ryood/PSoC-PyunPyun-3rdLPF/PSoC_PyunPyun_3rdLPF.cydsn/ComponentUpdateLog.txt

Last Modified Date & Time: 04/29/2015 00:29:26

PSoC_PyunPyun_3rdLPF: TopDesign
	ADC_SAR_Seq [v2.0] to [v2.10]
