ryood/PSoC-PyunPyun-3rdLPF/PyunPyun3_Test.xlsx

PyunPyun3 3rdLPF シールド テスト表
 | 電源なし、部品の挿入なし
 | Point1 | Point2 | 値 | 2015.04.28 #1 | 2015.04.28 #2
 | IC1-1 | IC1-2 | 導通 | OK
 | IC1-1 | C2 | 導通 | NG | OK
 | IC1-1 | C3 | 導通 | OK
 | IC1-3 | C1 | 導通 | OK
 | IC1-3 | R2 | 導通 | OK
 | IC1-4 | TP-GND | 導通 | OK
 | IC1-5 | R9 | 導通 | OK
 | IC1-5 | R10 | 導通 | OK
 | IC1-5 | TP-GND | 10kΩ | 9.97kΩ
 | IC1-5 | JP1-5 | 10kΩ | 9.90kΩ
 | IC1-6 | IC1-7 | 導通 | OK
 | IC1-7 | C7 | 導通 | OK
 | IC1-7 | C8 | 導通 | OK
 | IC1-7 | JP8 | 導通 | OK
 | IC1-8 | JP1-5 | 導通 | OK
 | R3 | JP8 | 導通 | OK
 | R3 | R5 | 導通 | OK
 | R3 | JP3-8 | 導通 | OK
 | R3 | C4 | 導通 | OK
 | R5 | C4 | 導通 | OK
 | R5 | R1 | 導通 | OK
 | C4 | R1 | 導通 | OK
 | R1 | R2 | 導通 | OK
 | R1 | C2 | 導通 | OK
 | C1 | TP-VGND | 導通 | OK
 | C3 | JP5-1 | 導通 | OK
 | C3 | TP-VGND | 10kΩ | 9.87kΩ
 | R4 | TP-VGND | 導通 | OK
 | JP1-4 | JP4-1 | 導通 | OK
 | JP1-5 | R9 | 導通 | OK
 | JP1-7 | TP-GND | 導通 | OK
 | R9 | C8 | 導通 | OK（裏面でチェック）
 | R9 | R10 | 導通 | OK
 | R10 | TP-GND | 導通 | OK
 | R10 | C7 | 導通 | OK（裏面でチェック）
 | JP3-1 | JP4-6 | 導通 | OK
 | JP3-2 | JP4-5 | 導通 | OK
 | JP3-5 | R6 | 導通 | OK
 | JP4-4 | TP-VGND | 導通 | OK
 | JP4-7 | TP-VGND | 2.2kΩ | 2.17kΩ
 | JP4-7 | R6 | 導通 | OK
 | JP4-8 | TP-GND | 導通 | OK
 | JP4-9 | JP1-5 | 1kΩ | 986Ω
 | C7 | TP-GND | 導通 | OK
 | C9 | JP1-5 | 導通 | OK
 | C9 | TP-VGND | 導通 | OK
 | C10 | TP-VGND | 導通 | OK
 | C10 | TP-GND | 導通 | OK
 | シールドをPSoCに挿入
 | Point1 | Point2 | 値 | 2015.04.28 #1
 | IC1-4 | TP-GND | 0V | 0.00mV
 | IC1-8 | TP-GND | 5V | 4.76V
 | JP4-1 | TP-GND | 3.3V | 3.47V
 | CR,OPAMP挿入(LCDは挿入しない)
 | Point1 | Point2 | 値 | 2015.04.28 #1
 | TP-AGND | TP-GND | 2.5V | 2.37V
