ryood/PSoC-PyunPyun-3rdLPF/(list of files, drawings)

Other design files:
Fritzing/PSoC_PyunPyun_3rdLPF.fzz
