ryood/PSoC-PyunPyun-3rdLPF/Eagle/PSoC_PyunPyun_Mini.brd

## EAGLE design Eagle/PSoC_PyunPyun_Mini.brd (2015-04-28)

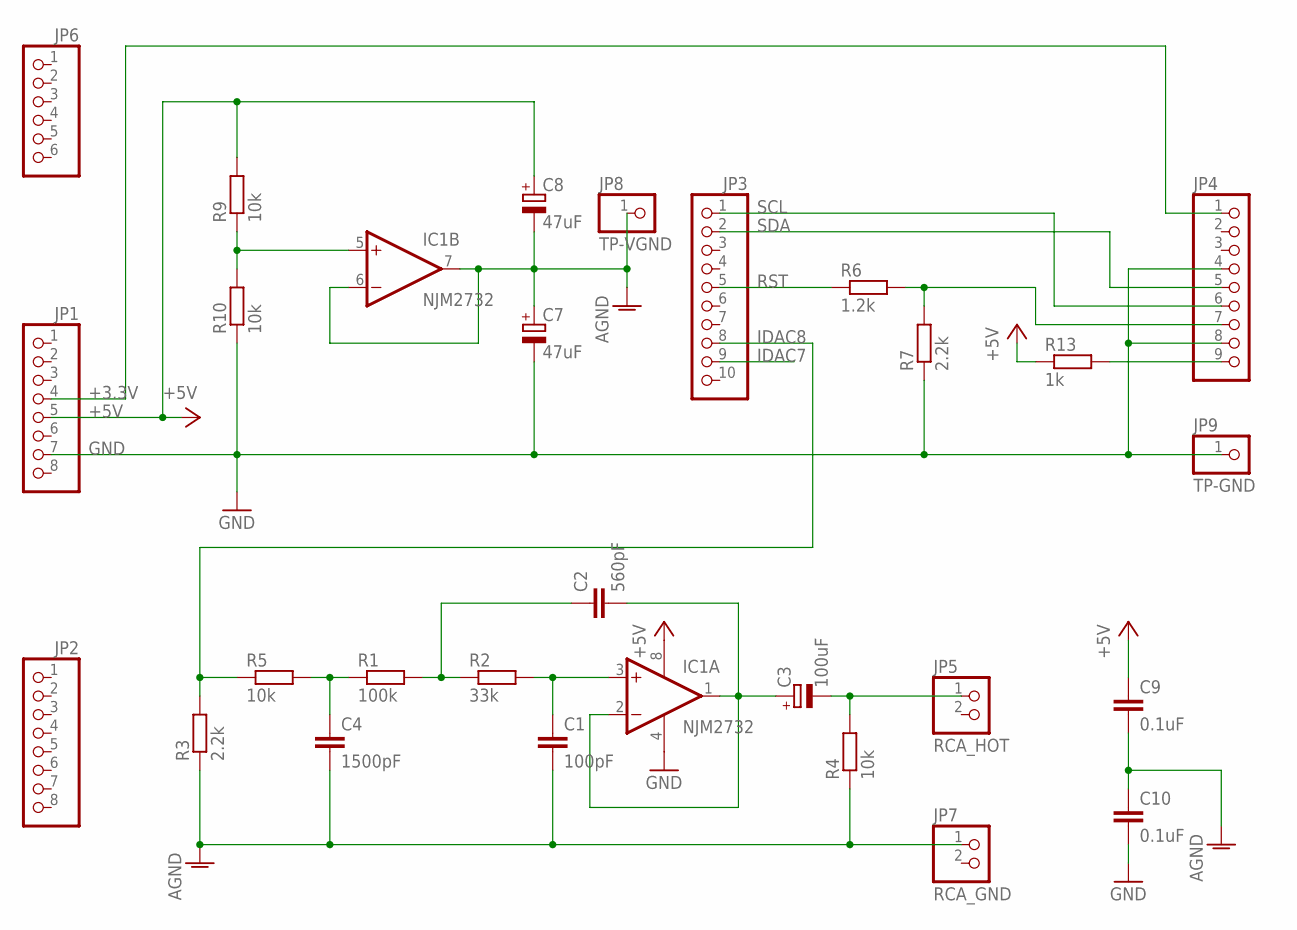
[picture p1: schematic PSoC_PyunPyun_Mini.sch]

Parts:
C1: 100pF; C050-024X044
C2: 560pF; C050-024X044
C3: 100uF; E2,5-7
C4: 1500pF; C050-024X044
C7, C8: 47uF; E2,5-5
C9, C10: 0.1uF; C050-024X044
IC1: NJM2732; DIL08
JP1, JP2: PINHD-1X8; 1X08
JP3: PINHD-1X10; 1X10
JP4: PINHD-1X9; 1X09
JP5: RCA_HOT; 1X02
JP6: PINHD-1X6; 1X06
JP7: RCA_GND; 1X02
JP8: TP-VGND; 1X01
JP9: TP-GND; 1X01
R1: 100k; 0207/7
R2: 33k; 0207/7
R3, R7: 2.2k; 0207/7
R4, R5, R9, R10: 10k; 0207/7
R6: 1.2k; 0207/7
R13: 1k; 0207/7

Connections:
+3.3V: JP1.4, JP4.1
+5V: C8.+, C9.1, IC1.8 (V+), JP1.5, R9.2, R13.1
AGND: C1.2, C4.2, C7.+, C8.-, C9.2, C10.1, IC1.6 (-IN), IC1.7 (OUT), JP7.1, JP8.1, R3.1, R4.1
GND: C7.-, C10.2, IC1.4 (V-), JP1.7, JP4.4, JP4.8, JP9.1, R7.1, R10.1
IDAC7: JP3.9
IDAC8: JP3.8, R3.2, R5.1
unnamed: C2.1, R1.2, R2.1
unnamed: C4.1, R1.1, R5.2
unnamed: C1.1, IC1.3 (+IN), R2.2
unnamed: C2.2, C3.+, IC1.1 (OUT), IC1.2 (-IN)
unnamed: JP4.9, R13.2
unnamed: JP3.5, R6.1
unnamed: C3.-, JP5.1, R4.2
unnamed: IC1.5 (+IN), R9.1, R10.2
RST: JP4.7, R6.2, R7.2
SCL: JP3.1, JP4.6
SDA: JP3.2, JP4.5

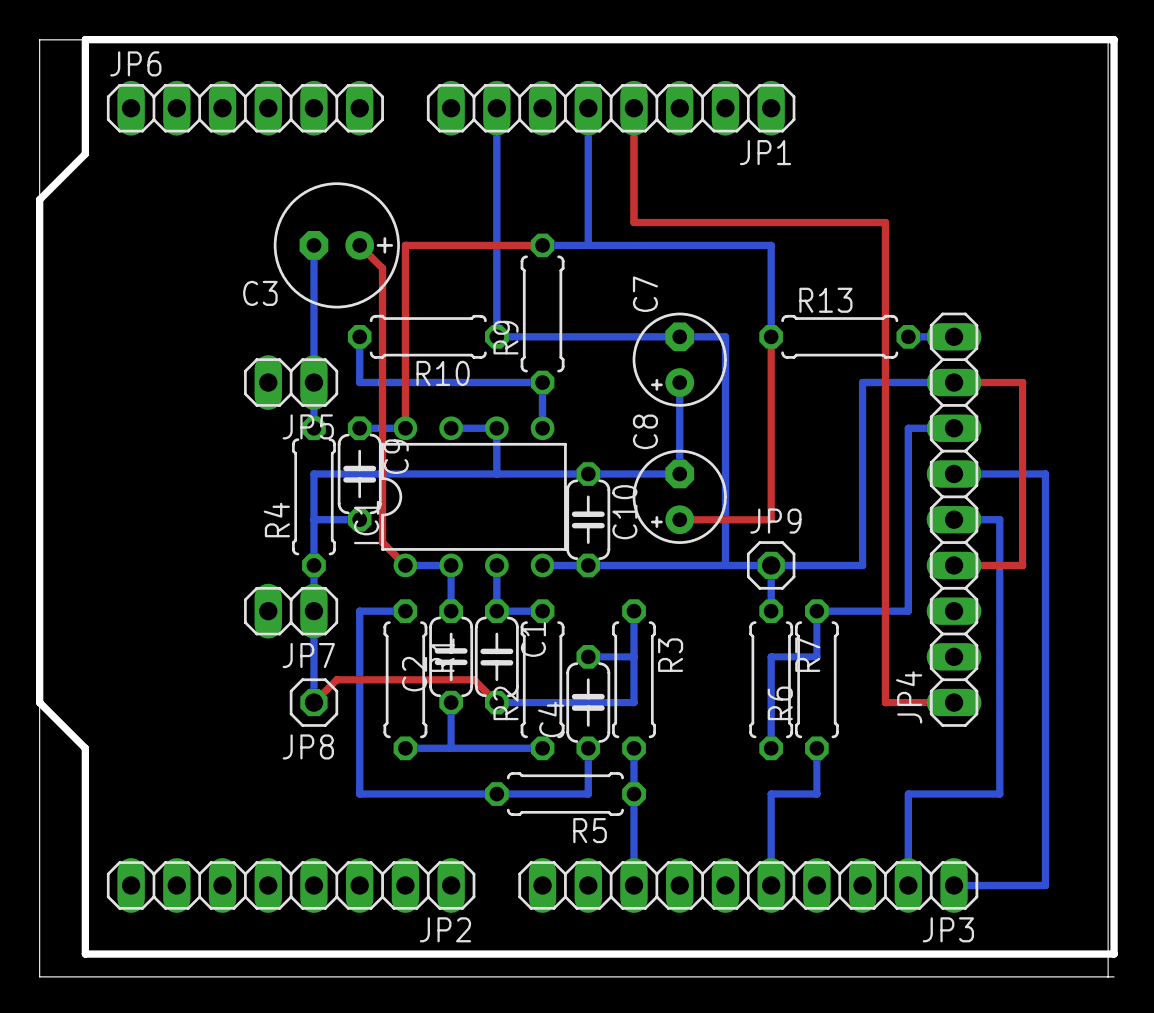
[picture p2: board PSoC_PyunPyun_Mini.brd from above]

Board: 2 copper layers, 59.7 x 52.1 mm, 28 parts (0 on the bottom side), 16 nets.
