ryood/PSoC-PyunPyun-3rdLPF/PSoC_PyunPyun_3rdLPF.cydsn/main.c

/* ========================================
 *
 * Copyright YOUR COMPANY, THE YEAR
 * All Rights Reserved
 * UNPUBLISHED, LICENSED SOFTWARE.
 *
 * CONFIDENTIAL AND PROPRIETARY INFORMATION
 * WHICH IS THE PROPERTY OF your company.
 *
 * ========================================
*/
#include <project.h>
#include <stdio.h>
#include <math.h>
#include "wavetable.h"

#define SAMPLE_CLOCK (48000.0f)

/* I2C slave address to communicate with */
#define I2C_LCD_ADDR	(0b0111110)

/* Buffer and packet size */
#define I2C_LCD_BUFFER_SIZE     (2u)
#define I2C_LCD_PACKET_SIZE     (I2C_LCD_BUFFER_SIZE)

/* Command valid status */
#define I2C_LCD_TRANSFER_CMPLT    (0x00u)
#define I2C_LCD_TRANSFER_ERROR    (0xFFu)

/* ADC channels */
#define ADC_CH_WAV_FREQ_N         (0x00u)
#define ADC_CH_LFO_FREQ_N         (0x01u)
#define ADC_CH_LFO_DEPT_N         (0x02u)

/* ADC limits */
#define ADC_LOW_LIMIT   ((int16)0x000)
#define ADC_HIGH_LIMIT  ((int16)0x7FF)

/* Wave Tables */
#define WAVE_SHAPE_N	(5)
#define WAVE_TABLE_LEN	(1024)

/* Wave & LFO Frequency Limit */
#define WAVE_FREQ_MAX   ((double)1000.0f)
#define LFO_FREQ_MAX    ((double)10.f)

/***************************************
* マクロ
****************************************/

/* Set LED RED color */
#define RGB_LED_ON_RED  \
                do{     \
                    LED_RED_Write  (0u); \
                    LED_GREEN_Write(1u); \
                }while(0)

/* Set LED GREEN color */
#define RGB_LED_ON_GREEN \
                do{      \
                    LED_RED_Write  (1u); \
                    LED_GREEN_Write(0u); \
                }while(0)

/* ADC limits trim */
#define ADC_LIMIT(x) \
    ((x)<ADC_LOW_LIMIT?ADC_LOW_LIMIT:((x)>=ADC_HIGH_LIMIT?ADC_HIGH_LIMIT:(x)))
                

/***************************************
* 大域変数
****************************************/

/* 波形パラメーター */
volatile double waveFrequency;
volatile double lfoFrequency;
volatile uint8 lfoDepth;
volatile uint8 waveShape;
volatile uint8 lfoShape;

const uint16 *waveTables[WAVE_SHAPE_N]; 

/* DDS用変数 */
volatile uint32 phaseRegister;
volatile uint32 tuningWord;

volatile uint32 lfoPhaseRegister;
volatile uint32 lfoTuningWord;
                
/* 入力デバイス用変数 */                
int16 adcResult[ADC_SAR_Seq_TOTAL_CHANNELS_NUM];
uint8 swWavForm;
uint8 swLfoForm;
uint8 prevSwWavForm = 0u;
uint8 prevSwLfoForm = 0u;

/* 表示用 */
const char *waveShapeStr[] = {
	"SIN", "TRI", "SQR", "SW1", "SW2"
};                
                
/*======================================================
 * LCD制御
 *              
 *======================================================*/

/* LCDのコントラストの設定 */
uint8 contrast = 0b100000;	// 3.0V時 数値を上げると濃くなります。
							// 2.7Vでは0b111000くらいにしてください。。
							// コントラストは電源電圧，温度によりかなり変化します。実際の液晶をみて調整してください。
                
uint32 LCD_Write(uint8 *buffer)
{
	uint32 status = I2C_LCD_TRANSFER_ERROR;
	
    I2CM_I2CMasterWriteBuf(I2C_LCD_ADDR, buffer, I2C_LCD_PACKET_SIZE, I2CM_I2C_MODE_COMPLETE_XFER);
    
	while (0u == (I2CM_I2CMasterStatus() & I2CM_I2C_MSTAT_WR_CMPLT))
    {
        /* Waits until master completes write transfer */
    }

    /* Displays transfer status */
    if (0u == (I2CM_I2C_MSTAT_ERR_XFER & I2CM_I2CMasterStatus()))
    {
        RGB_LED_ON_GREEN;

        /* Check if all bytes was written */
        if(I2CM_I2CMasterGetWriteBufSize() == I2C_LCD_BUFFER_SIZE)
        {
            status = I2C_LCD_TRANSFER_CMPLT;
			
			// １命令ごとに余裕を見て50usウェイトします。
			CyDelayUs(50);	
        }
    }
    else
    {
        RGB_LED_ON_RED;
    }

    (void) I2CM_I2CMasterClearStatus();
	   
	return (status);
}

// コマンドを送信します。HD44780でいうRS=0に相当
void LCD_Cmd(uint8 cmd)
{
	uint8 buffer[I2C_LCD_BUFFER_SIZE];
	buffer[0] = 0b00000000;
	buffer[1] = cmd;
	(void) LCD_Write(buffer);
}

// データを送信します。HD44780でいうRS=1に相当
void LCD_Data(uint8 data)
{
	uint8 buffer[I2C_LCD_BUFFER_SIZE];
	buffer[0] = 0b01000000;
	buffer[1] = data;
	(void) LCD_Write(buffer);
}

void LCD_Init()
{
	CyDelay(40);
	LCD_Cmd(0b00111000);	// function set
	LCD_Cmd(0b00111001);	// function set
	LCD_Cmd(0b00010100);	// interval osc
	LCD_Cmd(0b01110000 | (contrast & 0xF));	// contrast Low
	LCD_Cmd(0b01011100 | ((contrast >> 4) & 0x3)); // contast High/icon/power
	LCD_Cmd(0b01101100); // follower control
	CyDelay(300);
	
	LCD_Cmd(0b00111000); // function set
	LCD_Cmd(0b00001100); // Display On
}

void LCD_Clear()
{
	LCD_Cmd(0b00000001); // Clear Display
	CyDelay(2);	// Clear Displayは追加ウェイトが必要
}

void LCD_SetPos(uint32 x, uint32 y)
{
	LCD_Cmd(0b10000000 | (x + y * 0x40));
}

// （主に）文字列を連続送信します。
void LCD_Puts(char8 *s)
{
	while(*s) {
		LCD_Data((uint8)*s++);
	}
}

/*======================================================
 * 入力処理 
 *
 *======================================================*/
// ADC
void pollingADC()
{
    ADC_SAR_Seq_StartConvert();
    while (ADC_SAR_Seq_IsEndConversion(ADC_SAR_Seq_RETURN_STATUS) == 0u) {
        // 変換終了を待つ
        ;
    }
    adcResult[ADC_CH_WAV_FREQ_N] = ADC_LIMIT(ADC_SAR_Seq_GetResult16(ADC_CH_WAV_FREQ_N));
    adcResult[ADC_CH_LFO_FREQ_N] = ADC_LIMIT(ADC_SAR_Seq_GetResult16(ADC_CH_LFO_FREQ_N));
    adcResult[ADC_CH_LFO_DEPT_N] = ADC_LIMIT(ADC_SAR_Seq_GetResult16(ADC_CH_LFO_DEPT_N));
	
	waveFrequency = WAVE_FREQ_MAX * adcResult[ADC_CH_WAV_FREQ_N] / 2048;
	lfoFrequency = LFO_FREQ_MAX * adcResult[ADC_CH_LFO_FREQ_N] / 2048;
	lfoDepth = (uint8)(adcResult[ADC_CH_LFO_DEPT_N] / 8);
}

// Switches
void pollingSW()
{
    swWavForm = WAV_FORM_PIN_Read();
    if (swWavForm && !prevSwWavForm) {
        waveShape++;
		if (waveShape >= WAVE_SHAPE_N)
			waveShape = 0;
    }
	
    swLfoForm = LFO_FORM_PIN_Read();
    if (swLfoForm && !prevSwLfoForm) {
        lfoShape++;
		if (lfoShape >= WAVE_SHAPE_N)
			lfoShape = 0;
    }
	
    prevSwWavForm = swWavForm;
    prevSwLfoForm = swLfoForm;    
}

/*======================================================
 * 波形生成
 *
 *======================================================*/
CY_ISR(TimerISR_Handler)
{
	uint16 index;
	int32 waveValue, lfoValue;
	
	// Caluclate LFO Value
	//
	lfoPhaseRegister += lfoTuningWord;
	
	// 32bitのphaseRegisterをテーブルの10bit(1024個)に丸める
	index = lfoPhaseRegister >> 22;
	
	// lookupTable(11bit + 1bit) * (lfoDepth(8bit) -> 20bit) : 31bit + 1bit
    lfoValue = ((int32)(*(waveTables[lfoShape] + index)) - 2048) * ((int32)lfoDepth << 12);
	
	// tuningWord(32bit) * lfoValue(31bit + 1bit) : (63bit + 1bit) -> 31bit + 1bit
	lfoValue = (int32)(((int64)tuningWord * lfoValue) >> 31);
		
	// Caluclate Wave Value
	//
	phaseRegister += tuningWord + lfoValue;

	// 32bitのphaseRegisterをテーブルの10bit(1024個)に丸める
	index = phaseRegister >> 22;
    waveValue = *(waveTables[waveShape] + index);
	
	//DACSetVoltage(waveValue);
    IDAC8_SetValue(waveValue >> 4);
    IDAC7_SetValue(lfoValue >> 5);
    
    SamplingTimer_ClearInterrupt(SamplingTimer_INTR_MASK_TC);
}

/*======================================================
 * メインルーチン
 *
 *======================================================*/
int main()
{
    char  lcdLine[16 + 1];
    
    // 変数を初期化
	waveFrequency = 1000.0f;
	tuningWord = waveFrequency * pow(2.0, 32) / SAMPLE_CLOCK;
    phaseRegister = 0;
	
	lfoFrequency = 1.0f;
	lfoTuningWord = lfoFrequency * pow(2.0, 32) / SAMPLE_CLOCK;
    lfoPhaseRegister = 0;
    
    lfoDepth = 255;
	waveShape = 0;
	lfoShape = 0;
    
    waveTables[0] = waveTableSine;
    waveTables[1] = waveTableTriangle;
    waveTables[2] = waveTableSqure;
    waveTables[3] = waveTableSawtoothDown;
    waveTables[4] = waveTableSawtoothUp;
    
    // コンポーネントを初期化
    SamplingTimer_Start(); 
    TimerISR_StartEx(TimerISR_Handler);
        
    /* Init and start sequencing SAR ADC */
    ADC_SAR_Seq_Start();
    ADC_SAR_Seq_StartConvert();
    
    /* Init I2C LCD */
    I2CM_Start();
    
    CyGlobalIntEnable;
    
    // LCDをRESET
    CyDelay(500);
    LCD_RST_Write(0u);
    CyDelay(1);
    LCD_RST_Write(1u);
    CyDelay(10);
    
    LCD_Init();
    LCD_Clear();
    
	LCD_Puts("PyunPyun");
	
	LCD_SetPos(1, 1);
    LCD_Puts("Machine #3");
    
    CyDelay(1000);
    
    /* Start Wave Output */
    IDAC8_Start();
    IDAC7_Start();
    
    for(;;)
    {
        pollingADC();
        pollingSW();
        
        tuningWord = waveFrequency * pow(2.0, 32) / SAMPLE_CLOCK;
    	lfoTuningWord = lfoFrequency * pow(2.0, 32) / SAMPLE_CLOCK;
            
        sprintf(lcdLine, "FREQ LFO DPT %s", waveShapeStr[waveShape]);
        LCD_SetPos(0, 0);
        LCD_Puts(lcdLine);
        
        sprintf(
            lcdLine, "%4d%4d%4d %s",
            (int)waveFrequency,
			(int)(lfoFrequency * 10),
			lfoDepth,
            waveShapeStr[lfoShape]
            );
        LCD_SetPos(0, 1);
        LCD_Puts(lcdLine);
            
        //CyDelay(100);
    }
}

/* [] END OF FILE */
