ryood/PSoC-PyunPyun-3rdLPF/(commit log)

2015-04-10 change Bord Design
    [PSoC_PyunPyun_Mini.brd, PSoC_PyunPyun_Mini.sch]
2015-04-23 回路図・基板図 RST信号に抵抗分圧を追加
    [PSoC_PyunPyun_Mini.brd, PSoC_PyunPyun_Mini.sch]
2015-04-23 基板設計図 RST信号の分圧抵抗の位置を変更
    [PSoC_PyunPyun_Mini.brd]
2015-04-28 シールドの製作完了
    [PSoC_PyunPyun_Mini.brd]
2015-06-13 PyunPyun3_Test.xlsx: テスト表追加
    [PyunPyun3_Test.xlsx]
2015-06-13 main.c: 最大周波数を2000kHzに変更
2015-06-13 Backup: PSoC Creatorのバージョンアップに伴うBackupを追加
